urbanekmichal-dev/TetrisDevice/Tetris device.jpg

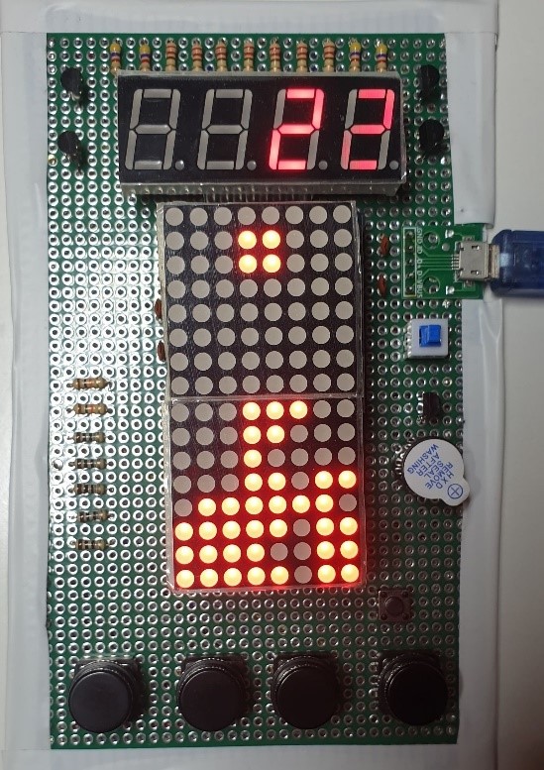
Tetris device.jpg
