urbanekmichal-dev/TetrisDevice/Presentation.pptx

## Gra retro - Tetris

Autor: Michał Urbanek

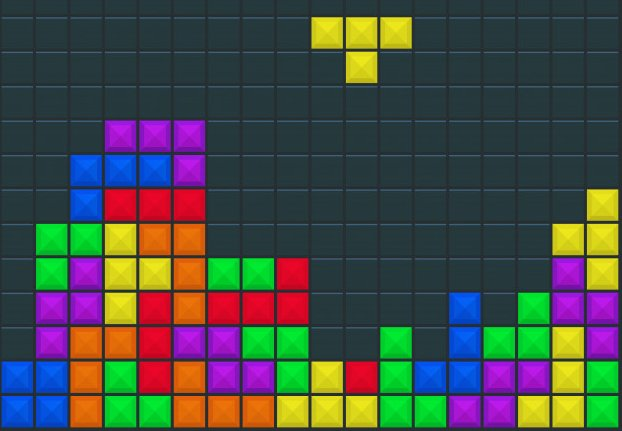
[picture p2: figure]

## Plan prezentacji

- Założenia projektu
- Analiza projektu
- Dobór części
- Schemat PCB
- Kosztorys
- Działanie układu
- Instrukcja użytkownika
- Wnioski

## Założenia projektu

- Gra składa się z dwóch lub więcej matryc (np. matryca 8x8 LED)
- Na matrycy generowane są bloki o losowym kształcie
- Za pomocą przycisków można dowolnie przesuwać oraz rotować spadające bloki
- Rozgrywce towarzyszą efekty dźwiękowe oraz melodia startowa
- Gra kończy się w momencie wypełnienia pola gry w pionie
- Zasilanie odbywa się za pomocą powerbanka lub innego urządzania 5V

## Schemat Blokowy

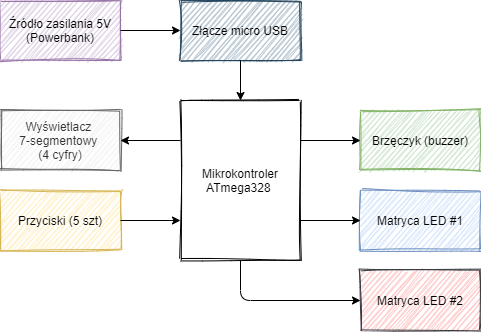
[picture p3: figure]

## Schemat ideowy

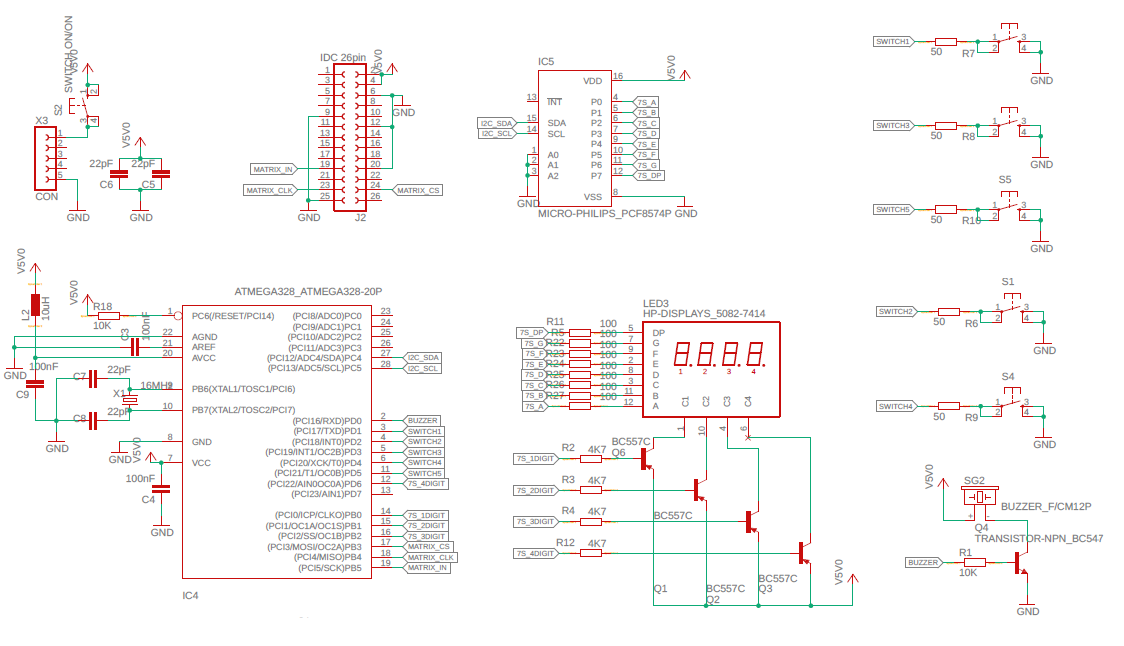
[picture p4: figure]

## Dobór części

- ATmega328P-U
- Obudowa przewlekana
- Obszerna dokumentacja
- Duża dostępność

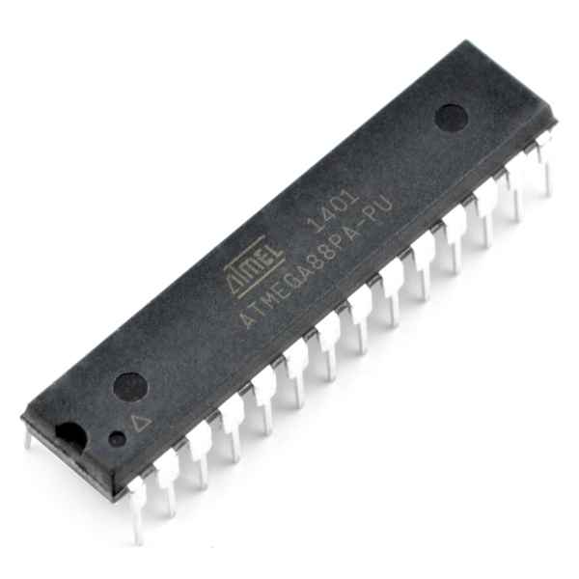
[picture p5: figure]

Matryca LED 16x8 MAX7219 Waveshare
- Kompletny układ
- Kompaktowe wymiary
- Dedykowany sterownik

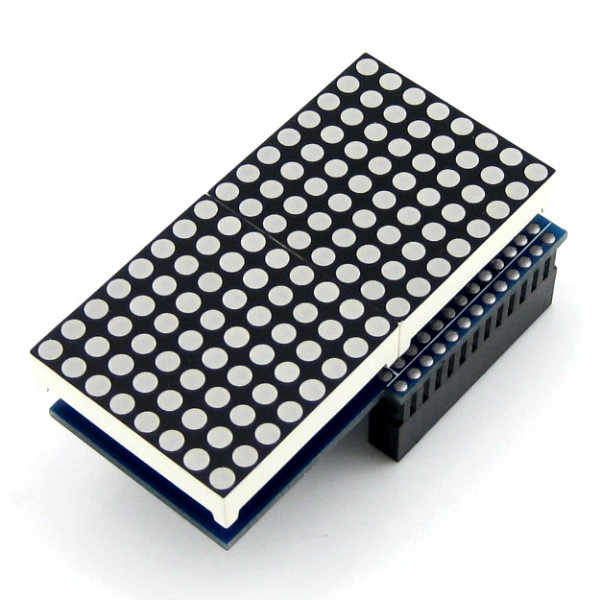
[picture p6: figure]

Wyświetlacz 7 segmentów 4 cyfry
- 4 cyfry w jednej obudowie
- Niski pobór energii
- Zgodność ze stylistyką

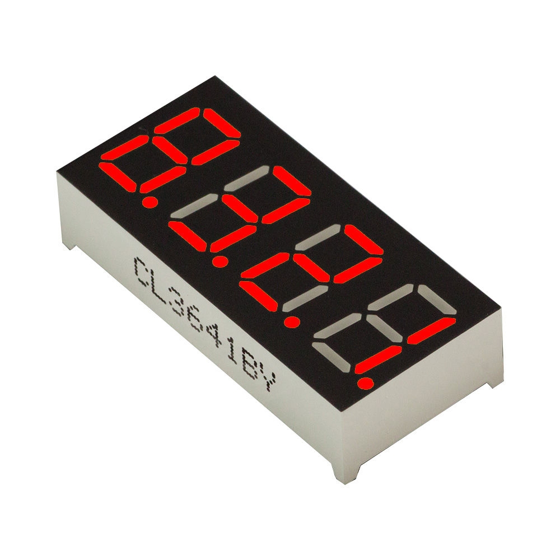
[picture p7: figure]

## Schemat PCB

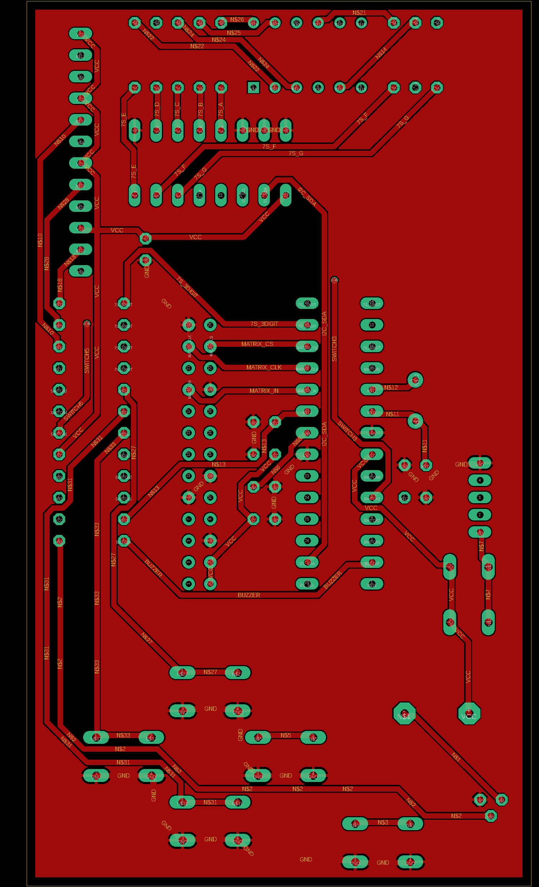
[picture p8: figure]
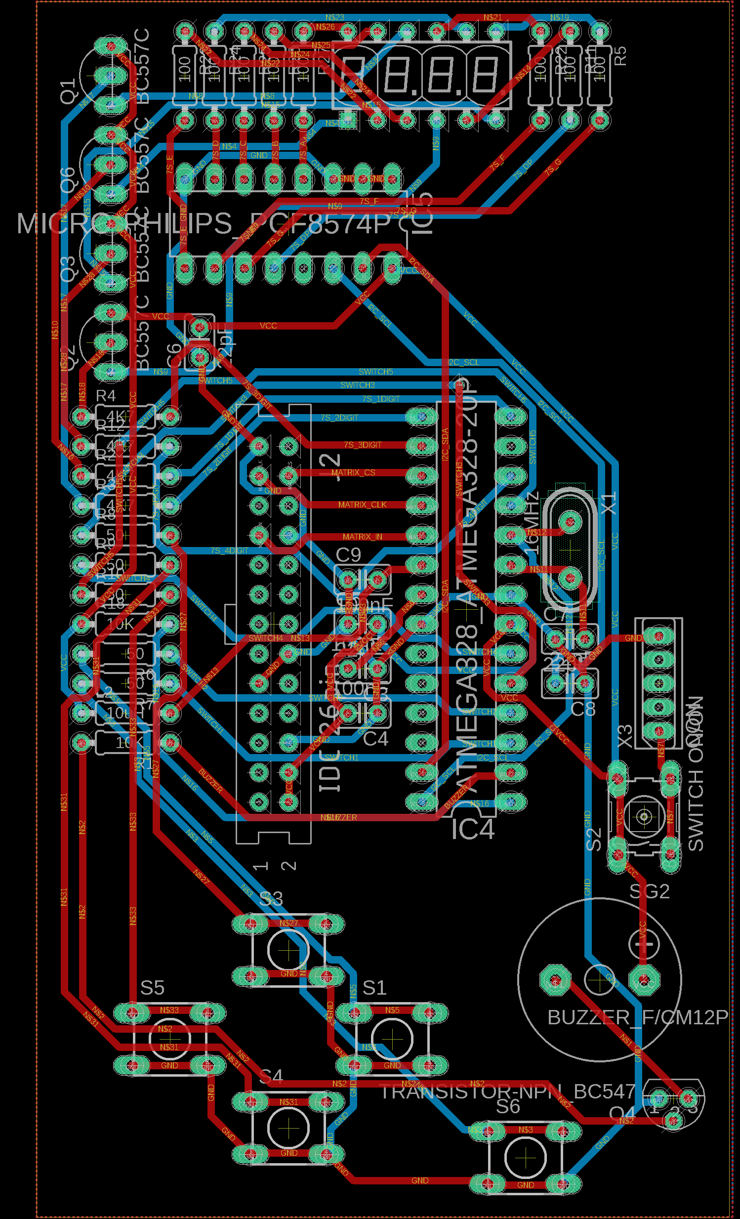
[picture p9: figure]
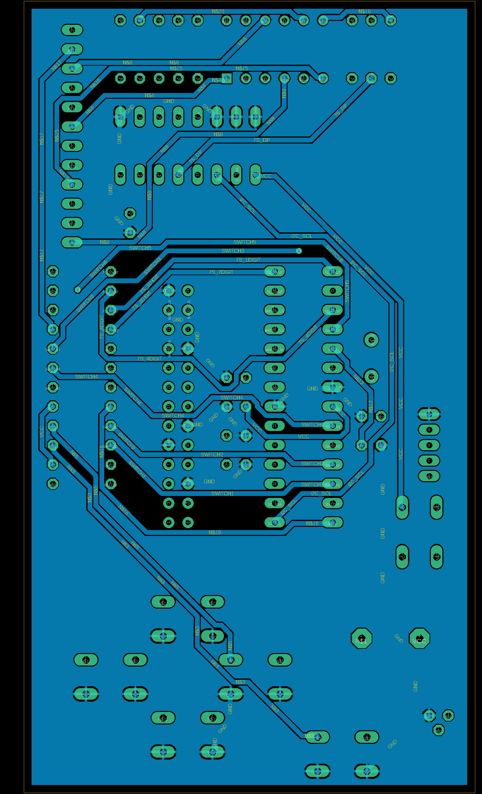
[picture p10: figure]

## Kosztorys

ELEMENT | CENA
Mikrokontroler ATmega328P-U | 13.90 zł
Matryca LED 16x8 Waveshare 9862 | 29.90 zł
Ekspander wyprowadzeń PCF8574N | 4.90 zł
Wyświetlacz 7 segmentowy 4 cyfry | 3.90 zł
Moduł gniazda Micro USB | 4.95 zł
Przyciski Tact-Switch (5szt) | 2.95 zł
Płytka uniwersalana 150x90mm | 11.00 zł
INNE (rezystory, kondensatory, dławiki,tranzystory,podstawki, przełączniki, rezonator,buzzer,przwody) | ~40.00 zł
Koszt dostaw | 25.00 zł
SUMA | ~140 zł

## Działanie układu

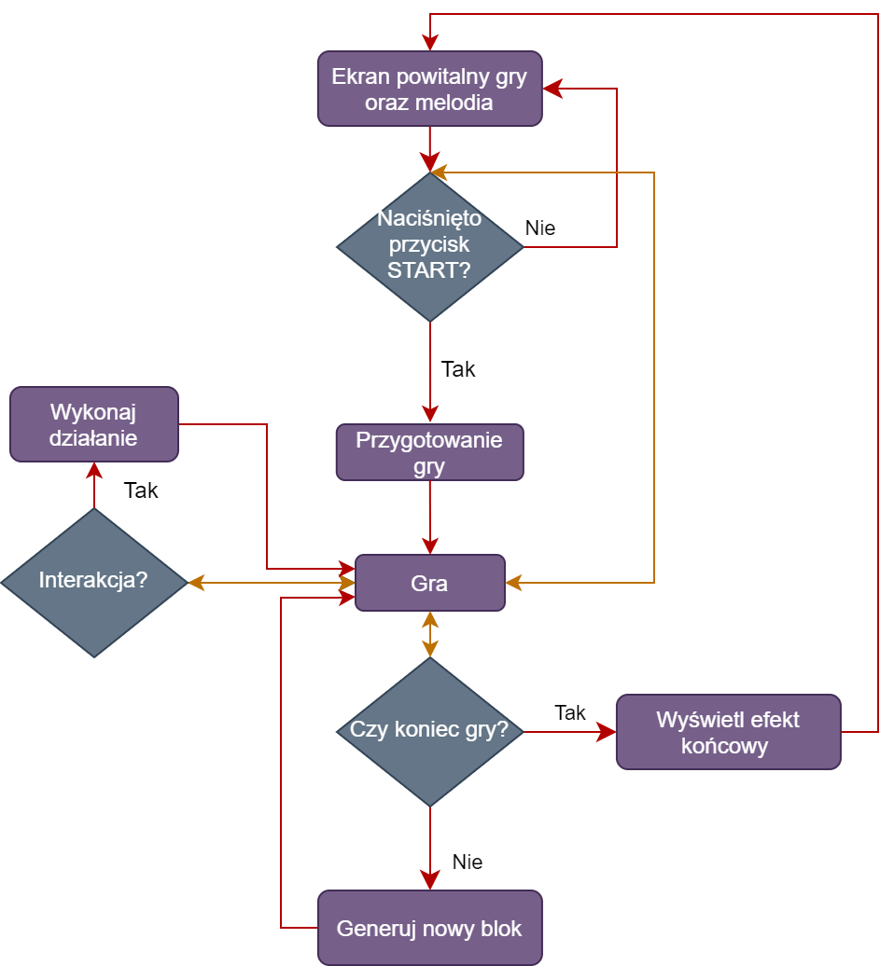
[picture p11: figure]

## Instrukcja użytkownika

- 1. Podłączyć urządznie do zasilania 5V (np. Powerbank lub port USB)
- 2. Nacisnąć przełącznik ON/OFF
- 3. Nacisnąć przycisk START
- 4. Cieszyć się rozgrywką

## Etap prac

- Prototypowanie układu oraz programowanie

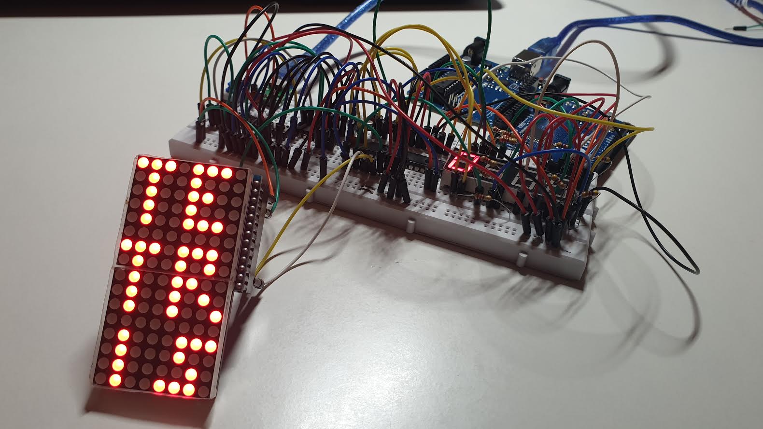
[picture p12: figure]

## Wnioski

- Programowanie urządzeń elektronicznych jest czasochłonne
- Nie wszytskie wstępne koncepcje i założenia okazują się prawidłowe na etapie obcowania z fizycznym urządzeniem
- Budowa urządzenia pozwala w łatwy sposób zweryfikować wiedzę teoretyczną
