urbanekmichal-dev/TetrisDevice/Projekt_wersja_finalna.ino

#include <LedControl.h>
#include <PCF8574.h>
#include <Wire.h>

PCF8574 expander;
// segment pin definitions
#define SegA   4
#define SegB   5
#define SegC   6
#define SegD    7
#define SegE    8
#define SegF    9
#define SegG    10
// common pins of the four digits definitions
#define Dig1    0
#define Dig2    1
#define Dig3    2
#define Dig4    3
 
// variable declarations
byte current_digit;
int  count = 0;

LedControl lc = LedControl(13, 12, 11, 2); // (dataPin, clockPin, csPin, totalDevices)
 
int lc0[] = {0, 0, 0, 0, 0, 0, 0, 0};
int lc1[] = {0, 0, 0, 0, 0, 0, 0, 0};
long active[] = {0, 0, 0, 0, 0, 0, 0, 0, 0, 0, 0, 0, 0, 0, 0, 0};
long screen[] = {0, 0, 0, 0, 0, 0, 0, 0, 0, 0, 0, 0, 0, 0, 0, 0};
int tmpCol = 0;
 
 
int figura = 0;
int figuraNext = 0;
int fromLeft = 0;
int fromRight = 0;
int angle = 0;
int colCheck = 0;
int moveCheck = 0;
int score = 0;
int started = 0;
int lcRows = 16;
int lcCols = 8;
int allLines = 0;
int currLines = 0;
int brickDelay = 0;
int defDelay = 500;
int level = 0;
 
boolean sound = true;
//Pinos
 
int rotate_button = 3; 
int left_button   = 2;
int down_button   = 1;
int right_button  = 0;
int start_button  = 4;
int speaker_pin   = 5;
int sound_button  = 4;
 
byte X[8] =
{
  0b00000,
  0b10001,
  0b01010,
  0b00100,
  0b01010,
  0b10001,
  0b00000,
  0b00000
};
 
byte O[8] =
{
  0b00000,
  0b11111,
  0b11111,
  0b11111,
  0b11111,
  0b11111,
  0b00000,
  0b00000
};
 
byte L[8] =
{
  0b11000,
  0b11000,
  0b11000,
  0b11000,
  0b11000,
  0b11111,
  0b11111,
  0b00000
};
 
byte J[8] =
{
  0b00011,
  0b00011,
  0b00011,
  0b00011,
  0b00011,
  0b11111,
  0b11111,
  0b00000
};
 
byte T[8] =
{
  0b00000,
  0b00000,
  0b11111,
  0b11111,
  0b01110,
  0b01110,
  0b00000,
  0b00000
};
 
byte I[8] =
{
  0b01100,
  0b01100,
  0b01100,
  0b01100,
  0b01100,
  0b01100,
  0b01100,
  0b00000
};
 
byte Z[8] =
{
  0b00000,
  0b00000,
  0b11110,
  0b11110,
  0b01111,
  0b01111,
  0b00000,
  0b00000
};
 
byte S[8] =
{
  0b00000,
  0b00000,
  0b01111,
  0b01111,
  0b11110,
  0b11110,
  0b00000,
  0b00000
};
 
//Nuty
int length = 99;
char notes[] = "EbCDCbaaCEDCbbCDECaa DFAGFEECEDCbbCDECaa EbCDCbaaCEDCbbCDECaa DFAGFEECEDCbbCDECaa ECDbCab ECDbCEAJ ";
int beats[] =      // Som
{
  2, 1, 1, 2, 1, 1, 2, 1, 1, 2, 1, 1, 2, 1, 1, 2, 2, 2, 2, 4, 2,
  2, 1, 2, 1, 1, 2, 1, 1, 2, 1, 1, 2, 1, 1, 2, 2, 2, 2, 4, 1,
  2, 1, 1, 2, 1, 1, 2, 1, 1, 2, 1, 1, 2, 1, 1, 2, 2, 2, 2, 4, 2,
  2, 1, 2, 1, 1, 2, 1, 1, 2, 1, 1, 2, 1, 1, 2, 2, 2, 2, 4, 1,
  5, 5, 5, 5, 5, 5, 7, 2, 5, 5, 5, 5, 2, 2, 5, 5, 3
};
int tempo = 128;        // Tempo
 
 
void playTone(int tone, int duration) {
  for (long i = 0; i < duration * 1000L; i += tone * 2) {
    expander.digitalWrite(speaker_pin, HIGH);
    delayMicroseconds(tone);
    expander.digitalWrite(speaker_pin, LOW);
    delayMicroseconds(tone);
  }
}
 
 
void playNote(char note, int duration) {
  char names[] = { 'c', 'd', 'e', 'f', 'g', 'a', 'b', 'C' , 'D', 'E', 'F', 'G', 'J', 'A', 'B'};
  int tones[] = { 1915, 1700, 1519, 1432, 1275, 1136, 1014, 956, 850, 760, 716, 637, 603, 568, 507 };
 
  for (int i = 0; i < 14; i++) {
    if (names[i] == note) {
      playTone(tones[i], duration);
    }
  }
}
 
 
void updateColumn(int colnum)
{
    lc0[colnum] = active[colnum] >> (lcRows / 2);
    lc1[colnum] = active[colnum];
    lc.setRow(0,colnum,(screen[colnum] >> (lcRows / 2)) | lc0[colnum]);
    lc.setRow(1,colnum,screen[colnum] | lc1[colnum]);
}
 
 
 
void buttonDelay(int bdelay)
{
    if(brickDelay > bdelay)
    {
        brickDelay -= bdelay;
    }
    delay(bdelay);
}
 
 
void splashScreen()
{
     int up[] =
     {
        B01110111,
        B00010010,
        B00110010,
        B00010010,
        B01110010,
        B00000000,
        B01110111,
        B01010010


     };
 
     int down[] =
     {
        B00110010,
        B01010010,
        B10010010,
        B00000000,
        B11100010,
        B00100010,
        B01000010,
        B01110010





     };
 
     for(int rownum = 0; rownum < 8; rownum++)
     {
         lc.setColumn(0,rownum,up[rownum]);
         lc.setColumn(1,rownum,down[rownum]);
     }
}
 
 
void setup() {
  expander.begin(0x20);
  pinMode(SegA, OUTPUT);
  pinMode(SegB, OUTPUT);
  pinMode(SegC, OUTPUT);
  pinMode(SegD, OUTPUT);
  pinMode(SegE, OUTPUT);
  pinMode(SegF, OUTPUT);
  pinMode(SegG, OUTPUT);
  pinMode(Dig1, OUTPUT);
  pinMode(Dig2, OUTPUT);
  pinMode(Dig3, OUTPUT);
  pinMode(Dig4, OUTPUT);
 
  disp_off();  // turn off the display
 
  // Timer1 module overflow interrupt configuration
  TCCR1A = 0;
  TCCR1B = 1;  // enable Timer1 with prescaler = 1 ( 16 ticks each 1 µs)
  TCNT1  = 0;  // set Timer1 preload value to 0 (reset)
  TIMSK1 = 1;  // enable Timer1 overflow interrupt

  
  expander.pinMode(speaker_pin,  OUTPUT);
  expander.pinMode(rotate_button,INPUT_PULLUP);
  expander.pinMode(down_button,  INPUT_PULLUP);
  expander.pinMode(right_button, INPUT_PULLUP);
  expander.pinMode(left_button,  INPUT_PULLUP);
  expander.pinMode(start_button, INPUT_PULLUP);
  expander.pinMode(sound_button, INPUT_PULLUP);
 
  lc.shutdown(0,false);
  lc.shutdown(1,false);
 
  lc.setIntensity(0,5);
  lc.setIntensity(1,5);
 
  lc.clearDisplay(0);
  lc.clearDisplay(1);

 
  randomSeed(analogRead(0));
}
 

ISR(TIMER1_OVF_vect)   // Timer1 interrupt service routine (ISR)
{
  disp_off();  // turn off the display
 
  switch (current_digit)
  {
    case 1:
     if(score+count>1000){
      disp(score+count / 1000);   // prepare to display digit 1 (most left)
      digitalWrite(Dig1, LOW);  // turn on digit 1
  }
      break;
 
    case 2:
    if(score+count>100){
      disp( (score+count / 100) % 10);   // prepare to display digit 2
      digitalWrite(Dig2, LOW);     // turn on digit 2
    }
      break;
 
    case 3:
      if(score+count>10){
      disp( (score+count / 10) % 10);   // prepare to display digit 3
      digitalWrite(Dig3, LOW);    // turn on digit 3
      }
      break;
 
    case 4:
      disp(score+count % 10);   // prepare to display digit 4 (most right)
      digitalWrite(Dig4, LOW);  // turn on digit 4
  }
 
  current_digit = (current_digit % 4) + 1;
  
}

void disp(byte number)
{
  switch (number)
  {
    case 0:  // print 0
      digitalWrite(SegA, LOW);
      digitalWrite(SegB, LOW);
      digitalWrite(SegC, LOW);
      digitalWrite(SegD, LOW);
      digitalWrite(SegE, LOW);
      digitalWrite(SegF, LOW);
      digitalWrite(SegG, HIGH);
      break;
 
    case 1:  // print 1
      digitalWrite(SegA, HIGH);
      digitalWrite(SegB, LOW);
      digitalWrite(SegC, LOW);
      digitalWrite(SegD, HIGH);
      digitalWrite(SegE, HIGH);
      digitalWrite(SegF, HIGH);
      digitalWrite(SegG, HIGH);
      break;
 
    case 2:  // print 2
      digitalWrite(SegA, LOW);
      digitalWrite(SegB, LOW);
      digitalWrite(SegC, HIGH);
      digitalWrite(SegD, LOW);
      digitalWrite(SegE, LOW);
      digitalWrite(SegF, HIGH);
      digitalWrite(SegG, LOW);
      break;
 
    case 3:  // print 3
      digitalWrite(SegA, LOW);
      digitalWrite(SegB, LOW);
      digitalWrite(SegC, LOW);
      digitalWrite(SegD, LOW);
      digitalWrite(SegE, HIGH);
      digitalWrite(SegF, HIGH);
      digitalWrite(SegG, LOW);
      break;
 
    case 4:  // print 4
      digitalWrite(SegA, HIGH);
      digitalWrite(SegB, LOW);
      digitalWrite(SegC, LOW);
      digitalWrite(SegD, HIGH);
      digitalWrite(SegE, HIGH);
      digitalWrite(SegF, LOW);
      digitalWrite(SegG, LOW);
      break;
 
    case 5:  // print 5
      digitalWrite(SegA, LOW);
      digitalWrite(SegB, HIGH);
      digitalWrite(SegC, LOW);
      digitalWrite(SegD, LOW);
      digitalWrite(SegE, HIGH);
      digitalWrite(SegF, LOW);
      digitalWrite(SegG, LOW);
      break;
 
    case 6:  // print 6
      digitalWrite(SegA, LOW);
      digitalWrite(SegB, HIGH);
      digitalWrite(SegC, LOW);
      digitalWrite(SegD, LOW);
      digitalWrite(SegE, LOW);
      digitalWrite(SegF, LOW);
      digitalWrite(SegG, LOW);
      break;
    
    case 7:  // print 7
      digitalWrite(SegA, LOW);
      digitalWrite(SegB, LOW);
      digitalWrite(SegC, LOW);
      digitalWrite(SegD, HIGH);
      digitalWrite(SegE, HIGH);
      digitalWrite(SegF, HIGH);
      digitalWrite(SegG, HIGH);
      break;
 
    case 8:  // print 8
      digitalWrite(SegA, LOW);
      digitalWrite(SegB, LOW);
      digitalWrite(SegC, LOW);
      digitalWrite(SegD, LOW);
      digitalWrite(SegE, LOW);
      digitalWrite(SegF, LOW);
      digitalWrite(SegG, LOW);
      break;
 
    case 9:  // print 9
      digitalWrite(SegA, LOW);
      digitalWrite(SegB, LOW);
      digitalWrite(SegC, LOW);
      digitalWrite(SegD, LOW);
      digitalWrite(SegE, HIGH);
      digitalWrite(SegF, LOW);
      digitalWrite(SegG, LOW);
  }
}
 
void disp_off()
{
   digitalWrite(Dig1, HIGH);
   digitalWrite(Dig2, HIGH);
   digitalWrite(Dig3, HIGH);
   digitalWrite(Dig4, HIGH);
}
 
//LOOP
void loop()
{
  if(started == 0)
  {
    splashScreen();
    
    for (int i = 0; i < length; i++)
    {
 
 if(expander.digitalRead(sound_button) == LOW)
 {
  sound =! sound;
  
  delay(300);
  }
 
         if(expander.digitalRead(start_button) == LOW)
         {
             started = 1;
             count=0;
             break;
         }
         if (notes[i] == ' ')
         {
             delay(beats[i] * tempo);   //Pausa
         }
         else
         {
          if (sound == 1){
             playNote(notes[i], beats[i] * tempo);
          }
          else
          {
             expander.digitalWrite(speaker_pin,LOW);
            }
         }
 
 
        delay(tempo / 2);
     }
 }
 
 
 
 else
 {
 
     lc.clearDisplay(0);
     lc.clearDisplay(1);
     memset(lc0, 0, sizeof(lc0));
     memset(lc1, 0, sizeof(lc1));
     memset(active, 0, sizeof(active));
     memset(screen, 0, sizeof(screen));
     tmpCol = 0;
 
     while(started == 1)
     {
        
 
         if(allLines < 100)
         {
             level = 0;              //Level 0
         }
         else if(allLines < 200)
         {
             level = 1;              //Level 1
         }
         else if(allLines < 300)
         {
             level = 2;              //Level 2
         }
         else if(allLines < 400)
         {
             level = 3;              //Level 3
         }
         else if(allLines < 500)
         {
             level = 4;              //Level 4
         }
         else
         {
             level = 5;              //Level 5
         }
 
 
         defDelay = (5 - level) * 100;
         brickDelay = defDelay;
 
 
         if(figura == 0)
         {
              figura = random(1,8);
              
         }
         else
         {
             figura = figuraNext;
             count++;
         }
         figuraNext = random(1,8);
         
         angle = 0;
         
 
         
 
         switch(figura)
         {
             case 1:
             //"O"
                 active[3] = 131072 + 65536;
                 active[4] = 131072 + 65536;
                 fromLeft = 3;
                 fromRight = 3;
                 break;
 
             case 2:
             //"L"
                 active[3] = 262144 + 131072 + 65536;
                 active[4] = 65536;
                 fromLeft = 3;
                 fromRight = 3;
                 break;
 
             case 3:
             //"J"
                 active[3] = 65536;
                 active[4] = 262144 + 131072 + 65536;
                 fromLeft = 3;
                 fromRight = 3;
                 break;
 
             case 4:
             //"T"
                 active[2] = 131072;
                 active[3] = 131072 + 65536;
                 active[4] = 131072;
                 fromLeft = 2;
                 fromRight = 3;
                 break;
 
             case 5:
             //"I"
                 active[3] = 524288 + 262144 + 131072 + 65536;
                 fromLeft = 3;
                 fromRight = 4;
                 break;
 
             case 6:
             //"Z"
                 active[2] = 131072;
                 active[3] = 131072 + 65536;
                 active[4] = 65536;
                 fromLeft = 2;
                 fromRight = 3;
                 break;
 
             case 7:
             //"S"
                 active[2] = 65536;
                 active[3] = 131072 + 65536;
                 active[4] = 131072;
                 fromLeft = 2;
                 fromRight = 3;
                 break;
         }
 
 
 
         for(int krok = 0; krok < lcRows + 1; krok++)
         {
             colCheck = 0;
 
 
             for(int i = 0; i < (lcCols / 2); i++)
             {
                 if((expander.digitalRead(left_button) == LOW) && (fromLeft > 0))
                 {
                  
                     moveCheck = 0;
                     for(int colnum = fromLeft; colnum < (lcCols - fromRight); colnum++)
                     {
                         if((active[colnum] & screen[colnum - 1]) == 0)
                         {
                             moveCheck++;
                         }
                     }
 
                     if(moveCheck == (lcCols - fromLeft - fromRight))
                     {
                         for(int colnum = (fromLeft - 1); colnum < (lcCols - fromRight); colnum++)
                         {
                             if(colnum < (lcCols - 1))
                             {
                                 active[colnum] = active[colnum+1];
                             }
                             else
                             {
                                 active[colnum] = 0;
                             }
                             updateColumn(colnum);
                         }
                         fromLeft--;
                         fromRight++;
                         playNote('E', 10);
                         buttonDelay(200);
                     }
                 }
             }
 
 
 
 
 
             for(int i = 0; i < (lcCols / 2); i++)
             {
                 if((expander.digitalRead(right_button) == LOW) && (fromRight > 0))
                 {
                     moveCheck = 0;
                     for(int colnum = fromLeft; colnum < (lcCols - fromRight); colnum++)
                     {
                         if((active[colnum] & screen[colnum + 1]) == 0)
                         {
                             moveCheck++;
                         }
                     }
 
                     if(moveCheck == (lcCols - fromLeft - fromRight))
                     {
                         for(int colnum = (lcCols - fromRight); colnum > (fromLeft - 1); colnum--)
                         {
                             if(colnum > 0)
                             {
                                 active[colnum] = active[colnum-1];
                             }
                             else
                             {
                                 active[colnum] = 0;
                             }
                             updateColumn(colnum);
                         }
                         fromLeft++;
                         fromRight--;
                         playNote('E', 10);
                         buttonDelay(200);
                     }
                 }
             }
 
 
 
             if(expander.digitalRead(down_button) == LOW)
             {
                 brickDelay = 0;
                 playNote('b', 10);
             }
             else
             {
                 brickDelay = defDelay;
             }
 
 
 
             for(int i = 0; i < (lcCols / 2); i++)
             {
                 if(expander.digitalRead(rotate_button) == LOW)
                 {
 
                     switch(figura)
                     {
                         case 1:
                         //"O"
                             break;
 
                         case 2:
                         //"L"
                             switch(angle)
                             {
                                 case 0:
                                 // . o .        . . .
                                 // . o .  --->  o o o
                                 // . o o        o . .
                                     if((fromLeft > 0)
                                     && (((active[fromLeft + 1] | (active[fromLeft + 1] << 1)) & screen[fromLeft - 1]) == 0))
                                     {
                                         active[fromLeft - 1] = (active[fromLeft + 1] | (active[fromLeft + 1] << 1));
                                         updateColumn(fromLeft - 1);
                                         active[fromLeft] = (active[fromLeft + 1] << 1);
                                         updateColumn(fromLeft);
                                         active[fromLeft + 1] = (active[fromLeft + 1] << 1);
                                         updateColumn(fromLeft + 1);
                                         fromLeft--;
                                         angle = 1;
                                     }
                                     break;
 
                                 case 1:
                                 // . . .        o o .
                                 // o o o  --->  . o .
                                 // o . .        . o .
                                     if((((active[fromLeft + 2] << 1) & screen[fromLeft]) == 0)
                                     && ((((active[fromLeft + 1] << 1) | (active[fromLeft + 1] >> 1)) & screen[fromLeft + 1]) == 0))
                                     {
                                         active[fromLeft] = (active[fromLeft + 2] << 1);
                                         updateColumn(fromLeft);
                                         active[fromLeft + 1] = active[fromLeft + 1] | (active[fromLeft + 1] << 1) | (active[fromLeft + 1] >> 1);
                                         updateColumn(fromLeft + 1);
                                         active[fromLeft + 2] = 0;
                                         updateColumn(fromLeft + 2);
                                         fromRight++;
                                         angle = 2;
                                     }
                                     break;
 
                                 case 2:
                                 // o o .        . . o
                                 // . o .  --->  o o o
                                 // . o .        . . .
                                     if((fromRight > 0)
                                     && (((active[fromLeft] >> 1) & screen[fromLeft]) == 0)
                                     && ((((active[fromLeft + 1] << 1) & active[fromLeft + 1]) & screen[fromLeft + 1]) == 0))
                                     {
                                         active[fromLeft] = (active[fromLeft] >> 1);
                                         updateColumn(fromLeft);
                                         active[fromLeft + 1] = active[fromLeft];
                                         updateColumn(fromLeft + 1);
                                         active[fromLeft + 2] = ((active[fromLeft + 1] << 1) | active[fromLeft + 1]);
                                         updateColumn(fromLeft + 2);
                                         fromRight--;
                                         krok--;
                                         angle = 3;
                                     }
                                     break;
 
                                 case 3:
                                 // . . o        . o .
                                 // o o o  --->  . o .
                                 // . . .        . o o
                                     if(((((active[fromLeft] << 1) | (active[fromLeft] >> 1)) & screen[fromLeft + 1]) == 0)
                                     && (((active[fromLeft] >> 1) & screen[fromLeft + 2]) == 0)
                                     && (krok < lcRows))
                                     {
                                         active[fromLeft] = 0;
                                         updateColumn(fromLeft);
                                         active[fromLeft + 1] = (active[fromLeft + 2] | (active[fromLeft + 2] >> 1));
                                         updateColumn(fromLeft + 1);
                                         active[fromLeft + 2] = ((active[fromLeft + 2] >> 1) & (active[fromLeft + 2] >> 2));
                                         updateColumn(fromLeft + 2);
                                         fromLeft++;
                                         krok++;
                                         angle = 0;
                                     }
                                     break;
                             }
                             break;
 
                         case 3:
                         //"J"
                             switch(angle)
                             {
                                 case 0:
                                 // . o .        o . .
                                 // . o .  --->  o o o
                                 // o o .        . . .
                                     if((fromRight > 0)
                                     && ((((active[fromLeft] << 2) | (active[fromLeft] << 1)) & screen[fromLeft]) == 0)
                                     && (((active[fromLeft] << 1) & screen[fromLeft + 2]) == 0))
                                     {
                                         active[fromLeft] = ((active[fromLeft] << 2) | (active[fromLeft] << 1));
                                         updateColumn(fromLeft);
                                         active[fromLeft + 1] = ((active[fromLeft + 1] << 1) & (active[fromLeft + 1] >> 1));
                                         updateColumn(fromLeft + 1);
                                         active[fromLeft + 2] = active[fromLeft + 1];
                                         updateColumn(fromLeft + 2);
                                         fromRight--;
                                         krok--;
                                         angle = 1;
                                     }
                                     break;
 
                                 case 1:
                                 // o . .        . o o
                                 // o o o  --->  . o .
                                 // . . .        . o .
                                     if((krok < lcRows)
                                     && ((((active[fromLeft + 1] << 1) | (active[fromLeft + 1] >> 1)) & screen[fromLeft + 1]) == 0)
                                     && (((active[fromLeft + 2] << 1) & screen[fromLeft + 2]) == 0))
                                     {
                                         active[fromLeft] = 0;
                                         updateColumn(fromLeft);
                                         active[fromLeft + 1] = (active[fromLeft + 1] | (active[fromLeft + 1] << 1) | (active[fromLeft + 1] >> 1));
                                         updateColumn(fromLeft + 1);
                                         active[fromLeft + 2] = (active[fromLeft + 2] << 1);
                                         updateColumn(fromLeft + 2);
                                         fromLeft++;
                                         krok++;
                                         angle = 2;
                                     }
                                     break;
 
                                 case 2:
                                 // . o o        . . .
                                 // . o .  --->  o o o
                                 // . o .        . . o
                                     if((fromLeft > 0)
                                     && (((active[fromLeft + 1] >> 1) & screen[fromLeft - 1]) == 0)
                                     && ((((active[fromLeft + 1] >> 1) | (active[fromLeft + 1] >> 2)) & screen[fromLeft + 1]) == 0))
                                     {
                                         active[fromLeft - 1] = (active[fromLeft + 1] >> 1);
                                         updateColumn(fromLeft - 1);
                                         active[fromLeft] = active[fromLeft - 1];
                                         updateColumn(fromLeft);
                                         active[fromLeft + 1] = (active[fromLeft] | (active[fromLeft + 1] >> 2));
                                         updateColumn(fromLeft + 1);
                                         fromLeft--;
                                         angle = 3;
                                     }
                                     break;
 
                                 case 3:
                                 // . . .        . o .
                                 // o o o  --->  . o .
                                 // . . o        o o .
                                     if((((active[fromLeft] >> 1) & screen[fromLeft]) == 0)
                                     && ((((active[fromLeft] << 1) | (active[fromLeft >> 1])) & screen[fromLeft + 1]) == 0))
                                     {
                                         active[fromLeft] = (active[fromLeft] >> 1);
                                         updateColumn(fromLeft);
                                         active[fromLeft + 1] = ((active[fromLeft + 1] << 1) | active[fromLeft + 2]);
                                         updateColumn(fromLeft + 1);
                                         active[fromLeft + 2] = 0;
                                         updateColumn(fromLeft + 2);
                                         fromRight++;
                                         angle = 0;
                                     }
                                     break;
                             }
                             break;
 
                         case 4:
                         //"T"
                             switch(angle)
                             {
                                 case 0:
                                 // . . .        . o .
                                 // o o o  --->  o o .
                                 // . o .        . o .
                                     if(((active[fromLeft + 1] << 1) & screen[fromLeft + 1]) == 0)
                                     {
                                         //active[fromLeft]
                                         active[fromLeft + 1] = active[fromLeft + 1] | (active[fromLeft + 1] << 1);
                                         updateColumn(fromLeft + 1);
                                         active[fromLeft + 2] = 0;
                                         updateColumn(fromLeft + 2);
                                         fromRight++;
                                         angle = 1;
                                     }
                                     break;
 
                                 case 1:
                                 // . o .        . o .
                                 // o o .  --->  o o o
                                 // . o .        . . .
                                     if((fromRight > 0)
                                     && ((active[fromLeft] & screen[fromLeft + 2])== 0))
                                     {
                                         //active[fromLeft]
                                         active[fromLeft + 1] = active[fromLeft + 1] & (active[fromLeft + 1] << 1);
                                         updateColumn(fromLeft + 1);
                                         active[fromLeft + 2] = active[fromLeft];
                                         updateColumn(fromLeft + 2);
                                         fromRight--;
                                         krok--;
                                         angle = 2;
                                     }
                                     break;
 
                                 case 2:
                                 // . o .        . o .
                                 // o o o  --->  . o o
                                 // . . .        . o .
                                     if((((active[fromLeft + 1] >> 1) & screen[fromLeft + 1]) == 0)
                                     && (krok < lcRows))
                                     {
                                         active[fromLeft] = 0;
                                         updateColumn(fromLeft);
                                         active[fromLeft + 1] = active[fromLeft + 1] | (active[fromLeft + 1] >> 1);
                                         updateColumn(fromLeft + 1);
                                         //active[fromLeft + 2]
                                         fromLeft++;
                                         krok++;
                                         angle = 3;
                                     }
                                     break;
 
                                 case 3:
                                     if((fromLeft > 0)
                                     && ((active[fromLeft + 1] & screen[fromLeft - 1]) == 0))
                                     {
                                         active[fromLeft - 1] = active[fromLeft + 1];
                                         updateColumn(fromLeft - 1);
                                         active[fromLeft] = active[fromLeft] & (active[fromLeft] >> 1);
                                         updateColumn(fromLeft);
                                         fromLeft--;
                                         angle = 0;
                                     }
                                     break;
                             }
                             break;
 
                         case 5:
                         //"I"
                             switch(angle)
                             {
                                 case 0:
                                 // . o . .        . . . .
                                 // . o . .  --->  o o o o
                                 // . o . .        . . . .
                                 // . o . .        . . . .
                                     if((fromLeft > 0)
                                     && (fromRight > 1)
 
                                     && ((((((active[fromLeft] >> 1) & (active[fromLeft] << 2)) & screen[fromLeft - 1]) & screen[fromLeft + 1]) & screen[fromLeft + 2]) == 0))
                                     {
                                         active[fromLeft - 1] = ((active[fromLeft] >> 1) & (active[fromLeft] << 2));
                                         updateColumn(fromLeft - 1);
                                         active[fromLeft] = active[fromLeft - 1];
                                         updateColumn(fromLeft);
                                         active[fromLeft + 1] = active[fromLeft];
                                         updateColumn(fromLeft + 1);
                                         active[fromLeft + 2] = active[fromLeft];
                                         updateColumn(fromLeft + 2);
                                         fromLeft--;
                                         fromRight -= 2;
                                         krok -= 2;
                                         angle = 1;
                                     }
                                     break;
 
                                 case 1:
                                 // . . . .        . . o .
                                 // o o o o  --->  . . o .
                                 // . . . .        . . o .
                                 // . . . .        . . o .
                                     if((krok < (lcRows - 1))
                                     && (((active[fromLeft] << 1) | (active[fromLeft] >> 1) | (active[fromLeft] >> 2)) & screen[fromLeft + 2]) == 0)
                                     {
                                         active[fromLeft] = 0;
                                         updateColumn(fromLeft);
                                         active[fromLeft + 1] = 0;
                                         updateColumn(fromLeft + 1);
 
                                         active[fromLeft + 2] = (active[fromLeft + 2] | (active[fromLeft + 2] << 1) | (active[fromLeft + 2] >> 1) | (active[fromLeft + 2] >> 2));
                                         updateColumn(fromLeft + 2);
                                         active[fromLeft + 3] = 0;
                                         updateColumn(fromLeft + 3);
                                         fromLeft += 2;
                                         fromRight++;
                                         krok += 2;
                                         angle = 2;
                                     }
                                     break;
 
                                 case 2:
                                 // . . o .        . . . .
                                 // . . o .  --->  . . . .
                                 // . . o .        o o o o
                                 // . . o .        . . . .
                                     if((fromLeft > 1)
                                     && (fromRight > 0)
 
                                     && ((((((active[fromLeft] << 1) & (active[fromLeft] >> 2)) & screen[fromLeft - 2]) & screen[fromLeft - 1]) & screen[fromLeft + 1]) == 0))
                                     {
                                         active[fromLeft - 2] = ((active[fromLeft] << 1) & (active[fromLeft] >> 2));
                                         updateColumn(fromLeft - 2);
                                         active[fromLeft - 1] = active[fromLeft - 2];
                                         updateColumn(fromLeft - 1);
                                         active[fromLeft] = active[fromLeft - 1];
                                         updateColumn(fromLeft);
                                         active[fromLeft + 1] = active[fromLeft];
                                         updateColumn(fromLeft + 1);
                                         fromLeft -= 2;
                                         fromRight--;
                                         krok--;
                                         angle = 3;
                                     }
                                     break;
 
                                 case 3:
                                 // . . . .        . o . .
                                 // . . . .  --->  . o . .
                                 // o o o o        . o . .
                                 // . . . .        . o . .
                                     if((krok < (lcRows))
                                     && (((active[fromLeft] >> 1) | (active[fromLeft] << 1) | (active[fromLeft] << 2)) & screen[fromLeft + 1]) == 0)
                                     {
                                         active[fromLeft] = 0;
                                         updateColumn(fromLeft);
 
                                         active[fromLeft + 1] = (active[fromLeft + 1] | (active[fromLeft + 1] >> 1) | (active[fromLeft + 1] << 1) | (active[fromLeft + 1] << 2));
                                         updateColumn(fromLeft + 1);
                                         active[fromLeft + 2] = 0;
                                         updateColumn(fromLeft + 2);
                                         active[fromLeft + 3] = 0;
                                         updateColumn(fromLeft + 3);
                                         fromLeft++;
                                         fromRight += 2;
                                         krok++;
                                         angle = 0;
                                     }
                                     break;
                             }
                             break;
 
                         case 6:
                         //"Z"
                             switch(angle)
                             {
                                 case 0:
                                 // . . .        . o .
                                 // o o .  --->  o o .
                                 // . o o        o . .
                                     if(((active[fromLeft + 1] & screen[fromLeft]) == 0)
                                     && (((active[fromLeft + 1] << 1) & screen[fromLeft + 1]) == 0))
                                     {
                                         active[fromLeft] = active[fromLeft + 1];
                                         updateColumn(fromLeft);
                                         active[fromLeft + 1] = (active[fromLeft + 1] << 1);
                                         updateColumn(fromLeft + 1);
                                         active[fromLeft + 2] = 0;
                                         updateColumn(fromLeft + 2);
                                         fromRight++;
                                         angle = 1;
                                     }
                                     break;
 
                                 case 1:
                                 // . o .        o o .
                                 // o o .  --->  . o o
                                 // o . .        . . .
                                     if((fromRight > 0)
                                     && ((((active[fromLeft] << 2) & (active[fromLeft] << 1)) & screen[fromLeft]) == 0)
                                     && (((active[fromLeft] & active[fromLeft + 1]) & screen[fromLeft + 2]) == 0))
                                     {
                                         active[fromLeft] = ((active[fromLeft] << 2) & (active[fromLeft] << 1));
                                         updateColumn(fromLeft);
                                         //active[fromLeft + 1]
                                         active[fromLeft + 2] = (active[fromLeft] >> 1);
                                         updateColumn(fromLeft + 2);
                                         fromRight--;
                                         krok--;
                                         angle = 2;
                                     }
                                     break;
 
                                 case 2:
                                 // o o .        . . o
                                 // . o o  --->  . o o
                                 // . . .        . o .
                                     if((krok < lcRows)
                                     && (((active[fromLeft + 1] >> 1) & screen[fromLeft + 1]) == 0)
                                     && (((active[fromLeft + 2] << 1) & screen[fromLeft + 2]) == 0))
                                     {
                                         active[fromLeft] = 0;
                                         updateColumn(fromLeft);
                                         active[fromLeft + 1] = (active[fromLeft + 1] >> 1);
                                         updateColumn(fromLeft + 1);
                                         active[fromLeft + 2] = (active[fromLeft + 2] | (active[fromLeft + 2] << 1));
                                         updateColumn(fromLeft + 2);
                                         fromLeft++;
                                         krok++;
                                         angle = 3;
                                     }
                                     break;
 
                                 case 3:
                                 // . . o        . . .
                                 // . o o  --->  o o .
                                 // . o .        . o o
                                     if((fromLeft > 0)
                                     && (((active[fromLeft] & active[fromLeft + 1]) & screen[fromLeft - 1]) == 0)
                                     && (((active[fromLeft + 1] >> 1) & screen[fromLeft + 1]) == 0))
                                     {
                                         active[fromLeft - 1] = (active[fromLeft] & active[fromLeft + 1]);
                                         updateColumn(fromLeft - 1);
                                         //active[fromLeft]
                                         active[fromLeft + 1] = (active[fromLeft - 1] >> 1);
                                         updateColumn(fromLeft + 1);
                                         fromLeft--;
                                         angle = 0;
                                     }
                                     break;
                             }
                             break;
 
                         case 7:
                         //"S"
                             switch(angle)
                             {
                                 case 0:
                                 // . . .        o . .
                                 // . o o  --->  o o .
                                 // o o .        . o .
                                     if(((active[fromLeft + 1] << 1) & screen[fromLeft]) == 0)
                                     {
                                         active[fromLeft] = (active[fromLeft + 1] << 1);
                                         updateColumn(fromLeft);
                                         //active[fromLeft + 1]
                                         active[fromLeft + 2] = 0;
                                         updateColumn(fromLeft + 2);
                                         fromRight++;
                                         angle = 1;
                                     }
                                     break;
 
                                 case 1:
                                 // o . .        . o o
                                 // o o .  --->  o o .
                                 // . o .        . . .
                                     if((fromRight > 0)
                                     && (((active[fromLeft + 1] << 1) & screen[fromLeft + 1]) == 0)
                                     && (((active[fromLeft] & (active[fromLeft] << 1)) & screen[fromLeft + 2]) == 0))
                                     {
                                         active[fromLeft] = (active[fromLeft] & active[fromLeft + 1]);
                                         updateColumn(fromLeft);
                                         active[fromLeft + 1] = (active[fromLeft + 1] << 1);
                                         updateColumn(fromLeft + 1);
                                         active[fromLeft + 2] = (active[fromLeft] << 1);
                                         updateColumn(fromLeft + 2);
                                         fromRight--;
                                         krok--;
                                         angle = 2;
                                     }
                                     break;
 
                                 case 2:
                                 // . o o        . o .
                                 // o o .  --->  . o o
                                 // . . .        . . o
                                     if((krok < lcRows)
                                     && (((active[fromLeft + 1] >> 1) & screen[fromLeft + 2]) == 0))
                                     {
                                         active[fromLeft] = 0;
                                         updateColumn(fromLeft);
                                         //active[fromLeft + 1]
                                         active[fromLeft + 2] = (active[fromLeft + 1] >> 1);
                                         updateColumn(fromLeft + 2);
                                         fromLeft++;
                                         krok++;
                                         angle = 3;
                                     }
                                     break;
 
                                 case 3:
                                 // . o .        . . .
                                 // . o o  --->  . o o
                                 // . . o        o o .
                                     if((fromLeft > 0)
                                     && ((active[fromLeft + 1] & ((active[fromLeft + 1] >> 1)) & screen[fromLeft - 1]) == 0)
                                     && ((active[fromLeft + 1] & screen[fromLeft]) == 0))
                                     {
                                         active[fromLeft - 1] = (active[fromLeft + 1] & (active[fromLeft + 1] >> 1));
                                         updateColumn(fromLeft - 1);
                                         active[fromLeft] = active[fromLeft + 1];
                                         updateColumn(fromLeft);
                                         active[fromLeft + 1] = (active[fromLeft - 1] << 1);
                                         updateColumn(fromLeft + 1);
                                         fromLeft--;
                                         angle = 0;
                                     }
                                     break;
                             }
                             break;
                     }
                     playNote('E', 10);
                     buttonDelay(200);
                 }
             }
 
 
             //Restart
             if(expander.digitalRead(start_button) == LOW)
             {
                 memset(lc0, 0, sizeof(lc0));
                 memset(lc1, 0, sizeof(lc1));
                 memset(active, 0, sizeof(active));
                 memset(screen, 0, sizeof(screen));
                 score = 0;
                 allLines = 0;
                 figura = 0;
                 count=0;
                 break;
             }
 
             for(int colnum = 0; colnum < lcCols; colnum++)
             {
 
                 if((screen[colnum] & (active[colnum] >> 1)) == 0)
                 {
                     colCheck++;
                 }
 
                 else
                 {
                     colCheck = 0;
                     if(krok == 0)
                     {
                         started = 0;
                     }
                 }
             }
 
             if((colCheck == lcCols) && (krok < lcRows))
             {
                 for(int colnum = 0; colnum < lcCols; colnum++)
                 {
                     active[colnum] = active[colnum] >> 1;
                     updateColumn(colnum);
                 }
             }
             else
             {
                 break;
             }
             delay(brickDelay);
         }
 
         for(int colnum = 0; colnum < lcCols; colnum++)
         {
             screen[colnum] = screen[colnum] | (lc0[colnum] << (lcRows / 2));
             screen[colnum] = screen[colnum] | lc1[colnum];
             lc0[colnum] = 0;
             lc1[colnum] = 0;
             active[colnum] = 0;
         }
 
 
 
         currLines = 0;
         for(int rownum = 0; rownum < lcRows; rownum++)
         {
             colCheck = 0;
             for(int colnum = 0; colnum < lcCols; colnum++)
             {
                 if(((screen[colnum] >> rownum) & 1) == 1)
                 {
                     colCheck++;
                 }
             }
             if(colCheck == lcCols)
             {
                 //Animacja kasowania
                 for(int colnum = 0; colnum < lcCols; colnum++)
                 {
                     tmpCol = ~((int) round(pow(2, rownum)));
                     screen[colnum] = screen[colnum] & tmpCol;
                     updateColumn(colnum);
 
                     switch(currLines)
                     {
                         case 0:
                             playNote('b', 20);
                             break;
                         case 1:
                             playNote('D', 20);
                             break;
                         case 2:
                             playNote('F', 20);
                             break;
                         case 3:
                             playNote('A', 20);
                             break;
                     }
                     delay(30);
 
                     tmpCol = (int) (round(pow(2, rownum)) - 1);
                     tmpCol = screen[colnum] & tmpCol;
                     screen[colnum] = (screen[colnum] >> (rownum + 1));
                     screen[colnum] = (screen[colnum] << rownum);
                     screen[colnum] = screen[colnum] | tmpCol;
 
                 }
 
 
                 for(int colnum = 0; colnum < lcCols; colnum++)
                 {
                     updateColumn(colnum);
                 }
                 rownum--;
                 currLines++;
                 allLines++;
             }
         }
 
         if(currLines > 0)
         {
             score += (int) round(pow(4, currLines-1));
         }
       
    }
 
gameOver();
// == Game Over ==
 
 }
}
 
void gameOver()
{
  playNote('F', 80);
  playNote('A', 60);
  playNote('F', 80);
  playNote('A', 60);
 
     int cima[] =
     {
         B11111111,   //     o     o o o
         B11111111,   //   o o o    o
         B11111111,   //   o   o     o o
         B11111111,   //     o     o
         B11111111,   //     o     o o o
         B11111111,   //
         B11111111,   //   o o o   o o o
         B11111111    //     o     o   o
     };
 
     int baixo[] =
     {
         B11111111,   //     o     o o
         B11111111,   //     o     o   o
         B11111111,   //     o     o     o
         B11111111,   //
         B11111111,   //     o       o o o
         B11111111,   //     o       o
         B11111111,   //     o         o
         B11111111    //     o     o o o
     };
 
 for(int rownum = 8; rownum >= 0; rownum--)
     {
         lc.setColumn(0,7-rownum,baixo[rownum]);
         delay(100);
     }
 
     for(int rownum = 8; rownum >= 0; rownum--)
     {
         lc.setColumn(1,7-rownum,cima[rownum]);
         delay(100);
     }
 
     delay(1800);
      
}
